mvp321/Modelling-and-Control-of-Cartesian-Coordinate-Robot/2.JPG

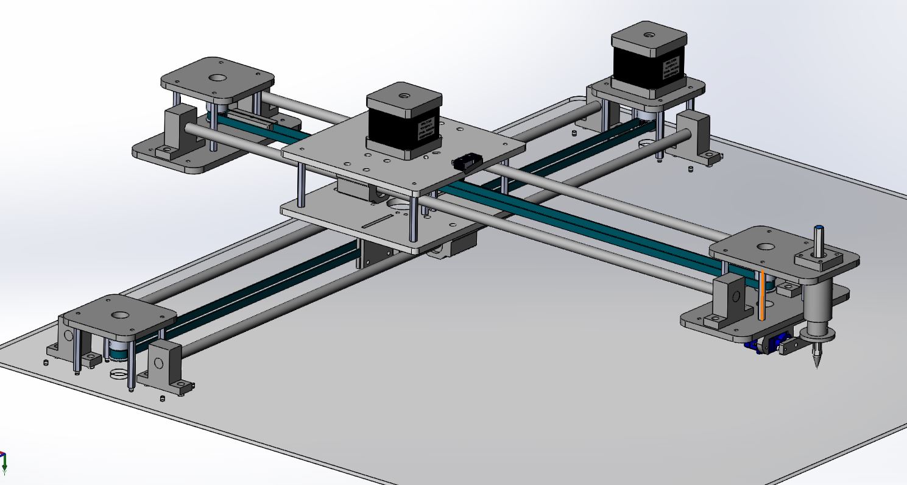
2.JPG
